jlaustill/ossm/images/OSSMInside.jpg

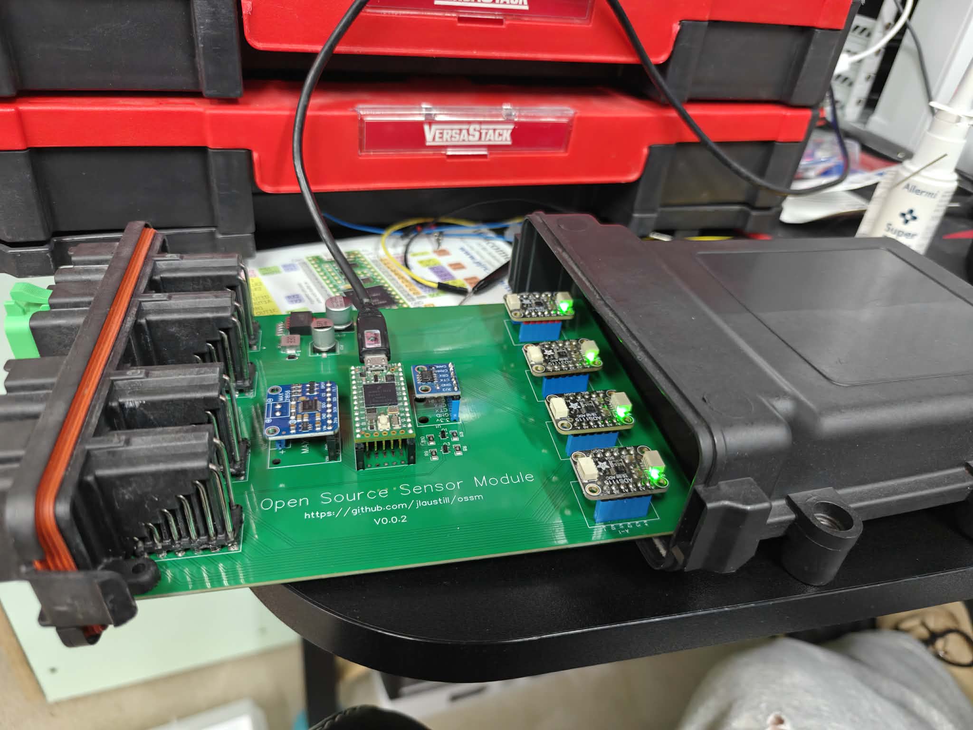
images/OSSMInside.jpg
