jlaustill/ossm/hardware/V0.0.2/Schematic_OSSM_2025-12-18.pdf

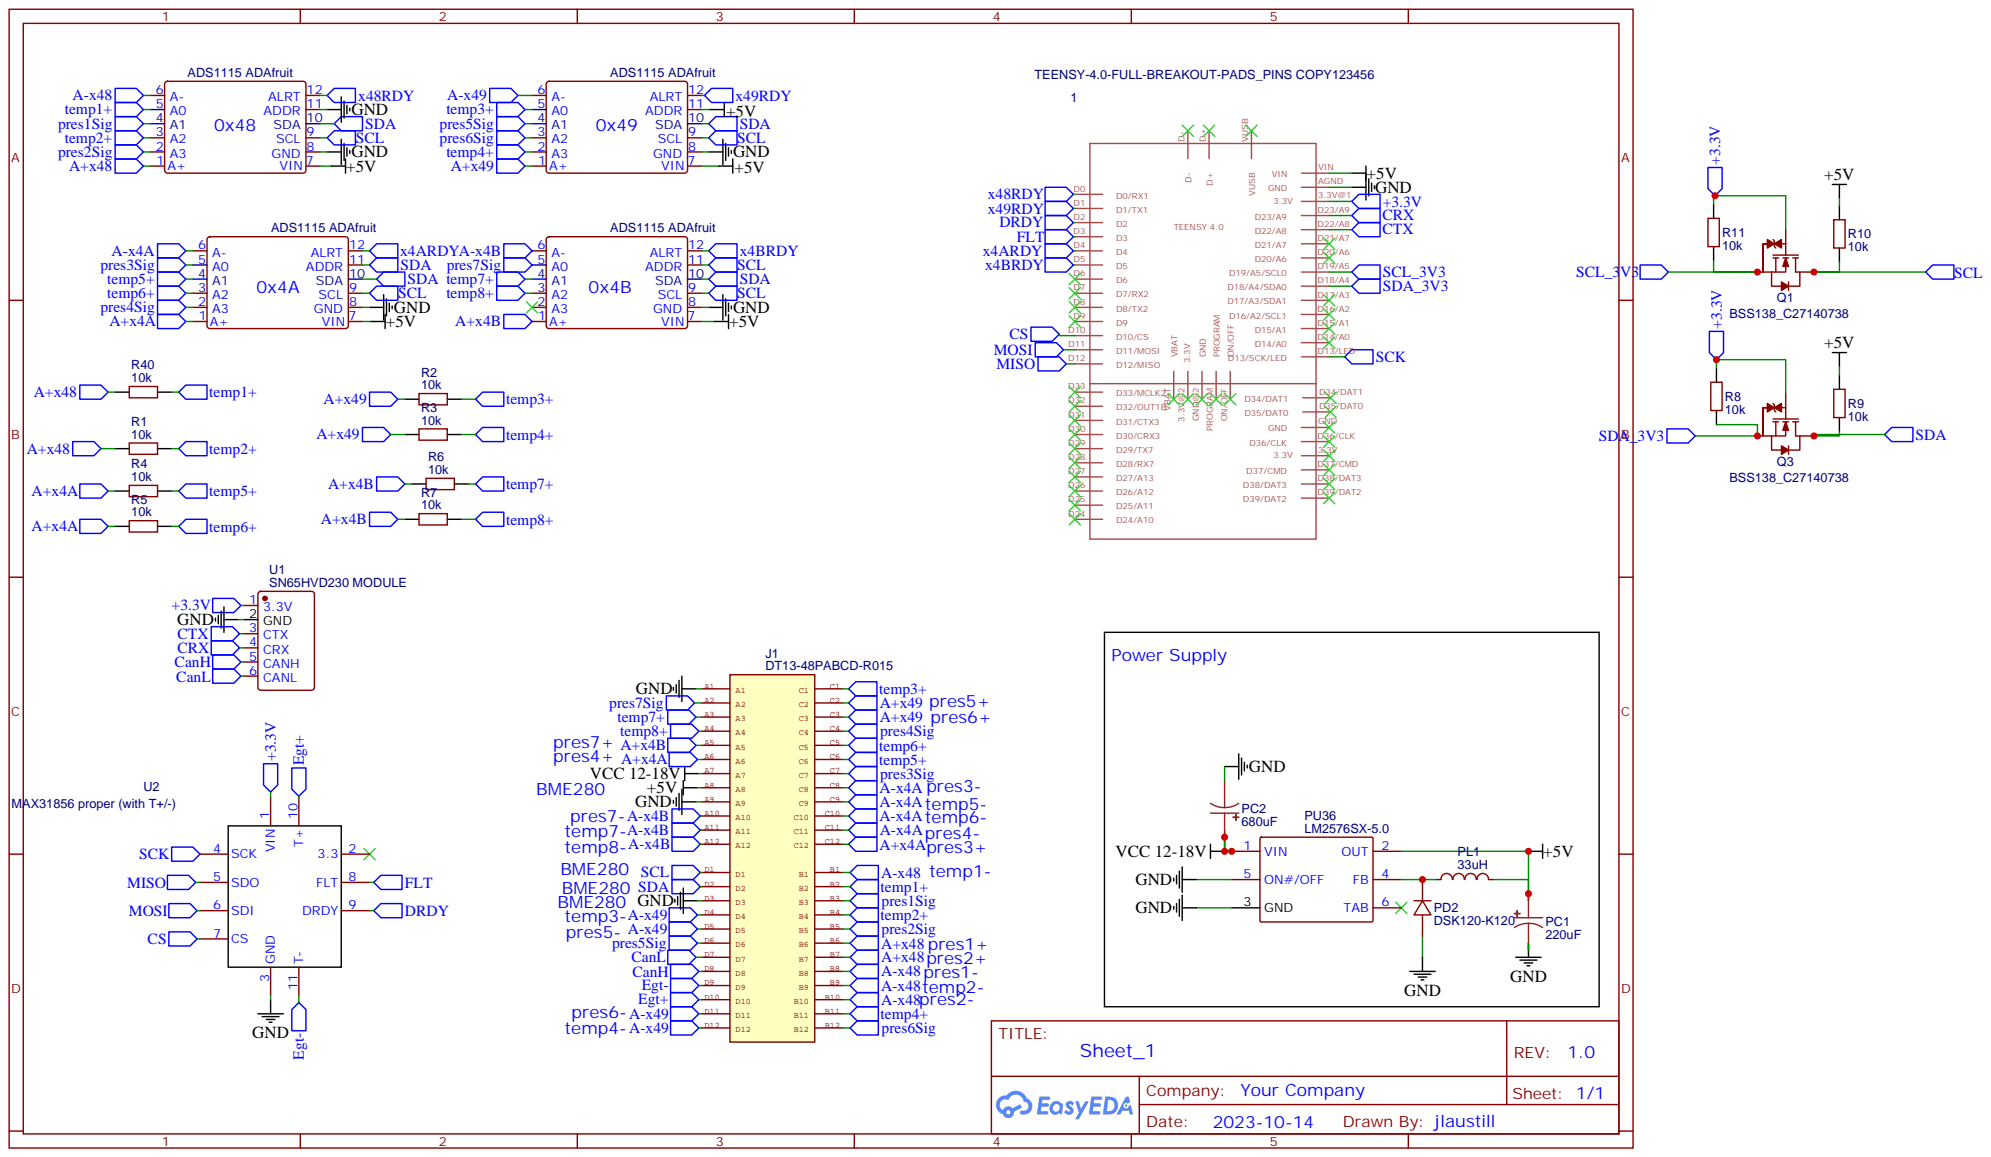
[picture p3: page 1]
