jlaustill/ossm/(commit log)

2023-10-29 add temp sensor code
2023-11-10 Everything is working on the test bench for sensors. Time to get all the ODB2 stuff figured out lol
2023-11-10 first two sensors working and setup with odb
2023-11-11 only positive pressures lol
2023-11-17 pressure sensor working accurately, yay
2024-11-11 handle millis only once per loop
2024-11-28 added configuration.h
    [configuration.h]
2024-12-20 added ability to be a repeater with a second canbus network
2025-12-14 smal bits
    [configuration.h]
2025-12-20 Refactor to async sensor architecture with runtime config
    Major architectural overhaul implementing 8-phase roadmap:
    - Replace blocking ADC reads with non-blocking ADS1115 continuous mode
    - Add 50ms IntervalTimer for deterministic sensor polling
    - Replace compile-time #ifdef config with EEPROM-based AppConfig
    - Add SerialCommandHandler for runtime configuration via USB
    - Create layered architecture: Data/Domain/Display/Interface
    New components:
    - ADS1115Manager: Round-robin polling of 4 ADC devices (16 channels)
    - MAX31856Manager: Non-blocking thermocouple with DRDY support
    - BME280Manager: Ambient temp, humidity, pressure
    - SensorProcessor: Raw ADC to engineering units conversion
    - Config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
    [configuration.h]
2025-12-20 Add unified command interface for J1939 and Serial configuration
    - Simplify AppConfig to input-based model (8 temp, 7 pressure inputs)
    - All sensors disabled by default on first boot
    - Add CSV command format for Serial (1,spn,enable,input)
    - Add binary command format for J1939 (PGN 65280/65281)
    - Support NTC calibration params and presets (AEM, Bosch, GM)
    - Support pressure range config and presets (100/150/200 PSI)
    - Auto-enable hi-res SPNs with standard counterparts
    - Fixed hardware mappings hide ADC complexity from user
    Commands: enable SPN, set NTC param, set pressure range, set TC type,
    query config, save, reset, NTC preset, pressure preset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
2025-12-21 Update README for new input-based command interface
    - Add Input Model section explaining temp1-8, pres1-7, EGT, BME280
    - Add Quick Start guide for easy onboarding
    - Replace old text commands with CSV integer format documentation
    - Add complete SPN Reference tables
    - Update Pinout to use temp/pres input naming
    - Clean up J1939 PGN section into concise table
    - Remove obsolete Sensors section and file structure references
    - Update Configuration section for new model
2025-12-21 Refactor SerialCommandHandler to use SeaDash::Parse
    - Replace strtok() with SeaDash::Parse::parse() for byte-only parsing
    - Change serial protocol to byte format (breaking change):
    - SPNs sent as highByte,lowByte (e.g., 1,0,175,1,3 for SPN 175)
    - Pressure range uses highByte,lowByte for PSI
    - Remove command 2 (float NTC params) - use presets instead
    - Update platformio.ini to use sea-dash from git (0.0.6+)
    - Add REFACTOR.md to track refactoring progress
2025-12-21 Update README for byte-based serial command format
    - Update command examples to use highByte,lowByte for SPNs
    - Remove Command 2 (NTC Calibration) - use presets instead
    - Add Command 3 documentation with byte format
    - Update file structure comment
2025-12-28 Add live sensor read command and fix EGT error spam
    - Add command 10 to read live sensor values over serial
    - 10,0: All active sensors
    - 10,1: EGT only
    - 10,2: Temperatures
    - 10,3: Pressures
    - 10,4: BME280
    - Remove MAX31856 fault spam from readResult()
    - Add fault reporting after all serial command responses
    - Fix data flow bug: EGT/BME280 now properly populate AppData
    - Update README with command 10 documentation
2025-12-28 Refactor command handling into unified CommandHandler
    - Create CommandHandler class in Domain layer as single source of truth
    - Fix bug: sensors now initialize on enable (no reboot required)
    - SerialCommandHandler and J1939Bus now delegate to CommandHandler
    - J1939 Save/Reset commands now actually work (were placeholders)
    - Eliminate ~200 lines of duplicated command logic
2025-12-28 Fix runtime temp/pressure sensor enable requiring reboot
    Initialize ADS1115Manager when enabling temperature or pressure SPNs
    at runtime, matching the pattern used for BME280 and EGT sensors.
    Without this, the ADC device remained disabled and returned invalid
    readings until the next reboot.
2025-12-28 Fix SPN reassignment and temp2/pres1 hardware mapping
    - When enabling an SPN on a new input, automatically clear any existing
    assignment of that SPN (move behavior instead of duplicate)
    - Fix hardware mapping for ADS1115 at 0x48:
    - temp2: channel 1 -> channel 2 (A2) per schematic
    - pres1: channel 2 -> channel 1 (A1) per schematic
2025-12-28 Fix 0x49 ADS1115 hardware mapping per schematic
    - temp4: channel 1 -> channel 3 (A3)
    - pres5: channel 2 -> channel 1 (A1)
    - pres6: channel 3 -> channel 2 (A2)
2025-12-29 Add PSIA/PSIG pressure support and fix CAN bus for v0.0.2
    - Add EPressureType enum for absolute (PSIA) vs gauge (PSIG) pressure
    - Expand pressure presets: 16 bar (0-3000) and 11 PSI (15-500) options
    - Use BME280 atmospheric pressure for PSIG-to-absolute conversion
    - Fix CAN bus to use CAN1 (D22/D23) for OSSM v0.0.2 hardware
    - Add missing msg.len = 8 to all J1939 CAN message structures
    - Store bar values in centibar, large values (>200 bar) as 20000+bar
2026-01-20 Add C-Next modules for J1939 encoding, SPN checking, and sensor conversion
    New memory-safe modules:
    - j1939_encode.cnx: J1939 SPN encoding (temp, pressure, humidity, boost)
    - spn_check.cnx: SPN enable checking with MISRA 13.5 compliance
    - sensor_convert.cnx: Steinhart-Hart thermistor and pressure conversion
    Integration:
    - J1939Bus.cpp uses j1939_encode_* and spn_check_* functions
    - SensorProcessor.cpp uses sensor_convert_* functions
    - Updated crc32.cnx to avoid runtime slice offsets (C-Next v0.1.12 compatibility)
    Firmware size: +384 bytes (47KB total)
2026-01-20 Update conversion progress with accurate line counts
    - j1939_encode: 71 lines (J1939 SPN encoding)
    - sensor_convert: 93 lines (Steinhart-Hart, pressure)
    - spn_check: 83 lines (MISRA 13.5 compliant)
    - Total: 323 lines of memory-safe C-Next code
    - Firmware size: +384 bytes
2026-01-21 Add presets.cnx module for NTC and pressure sensor presets
    C-Next conversion of sensor preset lookup tables:
    - NTC coefficients for AEM, Bosch, GM thermistor sensors
    - Pressure presets for bar (0-15) and PSI (20-30) ranges
    - Integrated with CommandHandler for preset application
    119 lines converted, total now 442 lines in C-Next.
2026-01-21 Add spn_category.cnx module for SPN category lookup
    C-Next conversion of SPN category lookup:
    - Maps SPNs to categories (temperature, pressure, EGT, BME280)
    - Provides hi-res SPN mapping (110→1637, 105→1363)
    - Replaces duplicate KNOWN_SPNS loops in CommandHandler and SerialCommandHandler
    Bugs found in v0.1.13:
    - Header declares extern without const for const variables (pending filing)
    - Header/implementation signature mismatch still present (#280)
    - Incorrect const on modified pointer parameter still present (#281)
    90 lines converted, total now 532 lines in C-Next.
2026-01-21 Add j1939_decode.cnx module for J1939 command parsing
    C-Next conversion of J1939 message decoding:
    - Parses SPN, enable flag, input from enable commands
    - Parses NTC param, pressure range, TC type commands
    - Parses query type/subquery and preset commands
    - Tests array parameter handling (const uint8_t data[8])
    Key finding: Array parameters work correctly in C-Next v0.1.13!
    The header/implementation signatures match for array types.
    118 lines converted, total now 650 lines in C-Next.
    Firmware: 47.3KB (+192 bytes)
2026-01-21 Add hardware_map.cnx module for ADS1115 sensor mapping
    C-Next conversion of hardware mapping lookup tables:
    - Maps temp inputs (0-7) to ADS1115 device/channel pairs
    - Maps pressure inputs (0-6) to ADS1115 device/channel pairs
    - Provides I2C address lookup for device indices
    - Includes input validation functions
    Integrated with SensorProcessor and ADS1115Manager.
    110 lines converted, total now 760 lines in C-Next.
    Firmware: 47.5KB (+128 bytes)
2026-01-21 Add byte_utils C-Next module for byte manipulation utilities
    Provides memory-safe implementations of common byte operations:
    - Endian conversion: makeU16BE, makeU16LE, makeU32BE, makeU32LE
    - Byte extraction: highByte, lowByte, byteN (for u32)
    - Bit manipulation: isBitSet, setBit, clearBit
    - Clamping: clampU8, clampU16, clampU32
    9 C-Next modules totaling 880 lines now converted.
2026-01-21 Add spn_info and input_valid C-Next modules, extend presets
    New modules:
    - spn_info.cnx (110 lines): SPN metadata lookup with index-based
    string table pattern, hi-res SPN mapping
    - input_valid.cnx (107 lines): Centralized input validation for
    temp/pressure inputs, TC types, query types, J1939 addresses
    Extended modules:
    - presets.cnx: Added isValidTcType() and defaultTcType()
    Integrations:
    - CommandHandler: Uses input_valid_* for all input validation
    - SerialCommandHandler: Uses spn_info_getIndex() with SPN_LABELS array
    12 C-Next modules totaling 1216 lines now converted.
    Firmware: 48164 bytes (+640 from new modules)
2026-01-21 Add j1939_bus and app_data C-Next modules (blocked by transpiler bugs)
    New C-Next modules:
    - j1939_bus.cnx: J1939 CAN bus communication (415 lines)
    - app_data.cnx: Application sensor data structure
    C-Next syntax improvements used:
    - Switch statements with brace syntax (no fallthrough)
    - Bit-slice syntax for byte extraction: encoded[0,8], encoded[8,8]
    - Cross-scope function calls: spn_check.isSpnEnabled()
    - MISRA-compliant: function results stored before if conditions
    Blocked by transpiler bugs (filed):
    - #294: Cross-scope calls keep dot notation instead of underscore
    - #295: C++ class instances initialized with = 0
    - #296: Forward declaration incompatible with typedef struct
    Also:
    - Delet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
2026-01-22 Rename C-Next scopes to PascalCase and reorganize file structure
    - Rename all C-Next scopes from snake_case to PascalCase (e.g., j1939_encode → J1939Encode)
    - Move all .cnx files to src/Display/ alongside their generated .cpp/.h files
    - Add main.cnx at src/ for Arduino entry point using C-Next
    - Update all C++ files to use new PascalCase function names (e.g., J1939Encode_temp16bit)
    - Keep J1939Bus as native C++ (class interface incompatible with C-Next generated code)
2026-01-22 Add ossm.cnx (blocked by transpiler bugs #313, #314, #315)
    Work-in-progress C-Next conversion of ossm.cpp. Currently blocked by:
    - #313: Scope-level variables generated as local instead of static
    - #314: global.X.method() generates . instead of :: for C++ calls
    - #315: Cross-file calls incorrectly add & to primitive struct members
2026-01-22 Fix PlatformIO C-Next integration and reduce build noise
    - cnext_build.py: Run transpilation immediately during pre: script phase
    instead of using AddPreAction (which wasn't triggering)
    - platformio.ini: Move strict warnings to build_src_flags so they only
    apply to project source, not framework/library headers
    Build blocked by C-Next issue #349 (angle-bracket includes missing
    directory prefix with --header-out)
2026-01-23 C-Next build pipeline working with v0.1.28
    Update cnext_build.py for C-Next v0.1.26+ CLI changes:
    - Change -I to --include flag
    - Add --include .pio for library header resolution
    - Add --no-cache for clean builds
    Full pipeline now working:
    - pio run automatically transpiles .cnx files
    - Compiles 52 files, collects 1027 symbols
    - Generates 34 output files
    - Build succeeds on Teensy 4.0
2026-01-23 Add EEPROM dump command and test firmware for C-Next validation
    - Add serial command 11 to dump raw EEPROM bytes as hex
    - Include pre-built firmware for A/B testing:
    - baseline-v0.1.2.hex: Pre-C-Next firmware (known good)
    - cnext-main.hex: Current C-Next transpiled firmware
    This enables byte-for-byte EEPROM comparison to validate C-Next
    transpilation preserves EEPROM read/write compatibility.
2026-01-23 Validate C-Next firmware on real Teensy 4.0 hardware
    Hardware validation successful:
    - BME280 (I2C): Ambient temp 20.2°C, humidity 25%, baro 89.08 kPa
    - MAX31856/EGT (SPI): Reading 25.6°C at ambient, no faults
    - EEPROM: Read/write/reset working correctly
    Note: CRC32 implementations differ between baseline and C-Next
    (field-by-field vs raw bytes), causing EEPROM migration to reset
    config. This is acceptable for fresh installs.
    Test artifacts included for reference.
2026-01-24 Convert SensorProcessor from C++ class to C-Next scope
    - Add SensorProcessor.cnx with C-Next implementation
    - Change interface: initialize() takes only config, processAllInputs()
    takes appData as parameter (pass-by-reference for mutations)
    - Extract function calls from if conditions (MISRA Rule 13.5)
    - Add -I include/Domain to platformio.ini for header resolution
    - Remove old C++ class header
2026-01-24 Add initialization guard to SensorProcessor
    Restore the null-check behavior from the original C++ implementation.
    If processAllInputs() is called before initialize(), return early to
    prevent silent processing with zero-initialized config.
2026-01-31 docs: add v0.1.2 release plan
    Comprehensive release preparation plan including:
    - Documentation restructure (end-user focused README)
    - New docs: ARCHITECTURE, SERIAL-COMMANDS, SPN-REFERENCE, HARDWARE-SETUP
    - Case sticker design (95x85mm SVG with pinout)
    - QA testing checklist
    - Release process with GitHub Release
2026-01-31 docs: prepare v0.1.2 release documentation
    - Add MIT LICENSE
    - Restructure README for end-users (quick-start focus, keep pinout)
    - Add CONTRIBUTING.md for developers
    - Create docs/ARCHITECTURE.md (technical design)
    - Create docs/SERIAL-COMMANDS.md (full serial reference)
    - Create docs/SPN-REFERENCE.md (complete SPN/PGN details)
    - Create docs/HARDWARE-SETUP.md (wiring guide)
    - Create docs/QA-CHECKLIST.md (release testing)
    - Move internal dev files to docs/internal/
    - Add case sticker SVG (95x85mm with QR code and pinout)
2026-02-03 docs: add data-driven J1939 encoding design
    Design for replacing hardcoded J1939 encoding functions with a
    config-driven approach:
    - EValueId enum for physical measurement locations
    - TSpnConfig with pgn, bytePos, resolution, offset, source value
    - TPgnConfig with J1939-specified transmission rates
    - Generic sendPgn() that builds messages from config
    - Hardware input assigns to values, SPNs auto-enable
    One sensor value can map to multiple SPNs with different resolutions.
    Adding new SPNs/PGNs requires only config entries, no new code.
    Blocked on C-Next issue #632 (u8 clamp) for implementation.
2026-02-03 fix: use default ADC gain for 0-5V sensor range
    The ADS1115 was explicitly set to GAIN_ONE (±4.096V) which couldn't
    read the full 0.5-4.5V pressure sensor range. Removed the setGain()
    call to use the library default GAIN_TWOTHIRDS (±6.144V), allowing
    full 0-5V measurement with 5V VDD.
    Also adds:
    - Debug command 12 to print ADC readings for QA
    - Debug logging in J1939Bus showing boost pressure encoding
    (reveals overflow bug when value > 510 kPa, see C-Next #632)
    - SPN 1127 now writes to boostPressurekPa for testing
2026-02-04 feat: add generic encode() function to J1939Encode
    Adds a generic encoding function that implements the J1939 formula:
    (value + offset) / resolution. Returns u16 to handle both 1-byte and
    2-byte SPNs. Clamping is handled by C-Next's default overflow behavior.
2026-02-04 feat: add SensorValues scope for centralized value storage
2026-02-04 feat: integrate SensorValues with ossm data flow
    Add updateSensorValues() helper that copies AppData sensor readings to the
    centralized SensorValues storage before J1939 transmission. Initialize
    SensorValues at startup.
2026-02-04 feat: add test function for generic PGN sender
    Add sendPgn65269Generic() to test the generic PGN sender against
    the hardcoded sendPgn65269() function. This enables verification
    that both produce identical CAN messages for the same sensor data.
2026-02-04 docs: update documentation for EValueId-based configuration
    Replace SPN-based command documentation with new value-based approach:
    - SERIAL-COMMANDS.md: Command 1 now assigns inputs to EValueId values
    instead of enabling SPNs directly
    - ARCHITECTURE.md: Add SensorValues scope, EValueId enum, TSpnConfig
    struct, and updated data flow diagrams
    - SPN-REFERENCE.md: Add value-to-SPN mapping table, update all examples
    to use new command format
    - README.md: Update quick start and J1939 configuration sections
    Key concept change: Users now think in terms of physical measurement
    locations (OIL_TEMP, MANIFOLD1_PRES) rather than J1939 SPN numbers.
    SPNs are automatically enabled when their source v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
2026-02-08 feat: populate hasHardware flags from config at boot and runtime
    Add J1939Config.findSourceForSpn() lookup helper to map SPN numbers
    to EValueId physical locations using the existing SPN_CONFIGS table.
    Wire hasHardware population into both boot (populateHardwareFlags in
    Ossm.setup) and runtime (CommandHandler enable/disable), so the
    generic PGN sender can determine which SPNs have real sensor hardware.
2026-02-10 feat: replace SPN-based config with EValueId physical measurement IDs
    Config now stores EValueId (physical measurement location) instead of
    J1939 SPNs, eliminating SPN knowledge from all layers except J1939
    encoding. CommandHandler is the single unified command processor with
    serial and CAN as thin transport layers. SensorProcessor writes
    directly to SensorValues. Six orphaned SPN-era files removed (-2364
    lines net).
2026-02-12 refactor: extract Hardware scope, add ValueName, simplify SensorValues
    - Extract hardware init into Hardware.cnx scope with single
    initialize(config) entry point, replacing scattered manager init
    calls in ossm.cnx and CommandHandler.cnx
    - Add ValueName.cnx with human-readable name lookup for EValueId
    values, used in SerialCommandHandler for readable serial output
    - Refactor SensorValues to use TSensorValue struct with public
    current[] array, removing getter/setter indirection
    - Simplify CommandHandler enable/disable to call Hardware.initialize()
    instead of per-manager init, fixing disable asymmetry
    - Simplify ossm.cnx setup by delegating to Hardware.initialize()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
2026-02-12 refactor: move config fallback logic into ConfigStorage.loadConfig
    ConfigStorage now owns the entire load-or-default lifecycle instead of
    leaking that concern into ossm.setup. Updated CLAUDE.md architecture
    to reflect current EValueId-based structure.
2026-02-12 refactor: move sensor timer and polling into SensorProcessor
    SensorProcessor now owns its ISR, IntervalTimer, and hardware manager
    polling. Ossm is a thin orchestrator that calls initialize() and update().
2026-02-12 docs: update CLAUDE.md — add transpile step, fix Teensy version, tighten workaround policy
2026-02-12 refactor: extract J1939CommandHandler from J1939Bus
    J1939Bus now owns CAN hardware, outbound PGNs, and ISR buffering.
    J1939CommandHandler owns inbound command dispatch, PGN scheduling,
    and CAN response formatting — symmetric with SerialCommandHandler.
    Config commands no longer processed in interrupt context.
2026-02-12 feat: throttle main loop to 500μs with temporary timing audit
    Loop now runs at 2kHz via elapsedMicros instead of every CPU cycle.
    Includes temporary per-subsystem timing report every 5 seconds.
2026-02-12 fix: restore critical block in getPendingCommand, drop this. workaround
    Both c-next bugs fixed in v0.1.69:
    - #778: critical block now compiles on Teensy 4.0
    - #779: array member access resolves without this. prefix
2026-02-12 refactor: rename sensorTimerCallback to sensorTimerISR for consistency
2026-02-12 refactor: optimize isValueAssigned with early bool checks and single loop
    Check EGT/BME280 flags first to avoid unnecessary iteration.
    Merge temp and pressure array scans into one pass.
2026-02-15 docs: document conflated Data layer concerns
    Analysis of src/Data/ files identifying architecture issues:
    - ConfigStorage.cnx: mixes persistence with physics presets (NTC coeffs)
    - ADS1115Manager.cnx: Data layer imports Display/HardwareMap.cnx (layering violation)
    - J1939Config.cnx: minimal lookup that could be optimized
    - SensorValues.cnx: direct access from Domain layer, no abstraction
    Proposed fixes:
    1. Split ADS1115Manager into ADS1115Driver (Data) + ADS1115Converter (Display)
    2. Move default physics to separate module from ConfigStorage
    3. Monitor J1939Config performance
2026-02-15 docs: fix SERIAL-COMMANDS.md command format
    Fix Command 1 format from `1,inputType,inputNum,valueId` to correct
    `1,valueId[,input]` syntax.
    Key corrections:
    - Command 1 now shows correct format: `1,valueId[,input]`
    - BME280/EGT values don't require input number
    - Temperature/pressure values require input number (1-8 / 1-7)
    - Added Command 2 (Disable Value) documentation
    - Reorganized examples for clarity
    - Added dedicated EGT/BME280 setup section
2026-02-15 refactor: auto-save all config changes, remove save/reset commands
    All configuration changes (enable/disable values, pressure range, TC type,
    NTC presets, pressure presets) now automatically save to EEPROM after
    execution. Commands 6 (Save) and 7 (Reset) are removed.
    Reordered remaining commands:
    1: Enable Value
    2: Disable Value
    3: Set Pressure Range
    4: Set TC Type
    5: Query Config
    7: NTC Preset (was 8)
    8: Pressure Preset (was 9)
    9: Read Sensors (was 10)
2026-02-15 docs: update all docs for auto-save, remove command 6
    - SERIAL-COMMANDS.md: Fixed command numbers (7/8/9), added auto-save note
    - ARCHITECTURE.md: Updated configuration flow to show auto-save
    - HARDWARE-SETUP.md: Removed reference to command 6 for save
    - QA-CHECKLIST.md: Removed Command 6 test, updated command numbering
2026-02-15 fix: print value names in read sensors command
    Changed handleReadSensors() to print actual value names (e.g., OIL_PRES,
    OIL_TEMP) instead of hardware input names (pres1, temp1) when reading
    live sensor values.
    Before: pres1: 285.74 kPa
    After: OIL_PRES: 285.74 kPa
2026-02-15 docs: fix pinout in README to match schematic
    Connector A pins 2, 5, 6, 10 were swapped - pres2 and pres7 labels were incorrect.
    Correct mapping:
    - Pin A2 = pres7 Signal (was pres2)
    - Pin A5 = pres7 + (was pres2 +)
    - Pin A6 = pres2 + (was pres7 +)
    - Pin A10 = pres7 - (was pres2 -)
2026-02-15 docs: reorder connector columns from ABCD to ACDB
    Matches physical left-to-right connector layout on the PCB.
